warrenjb/footpod/case/case_preview.png

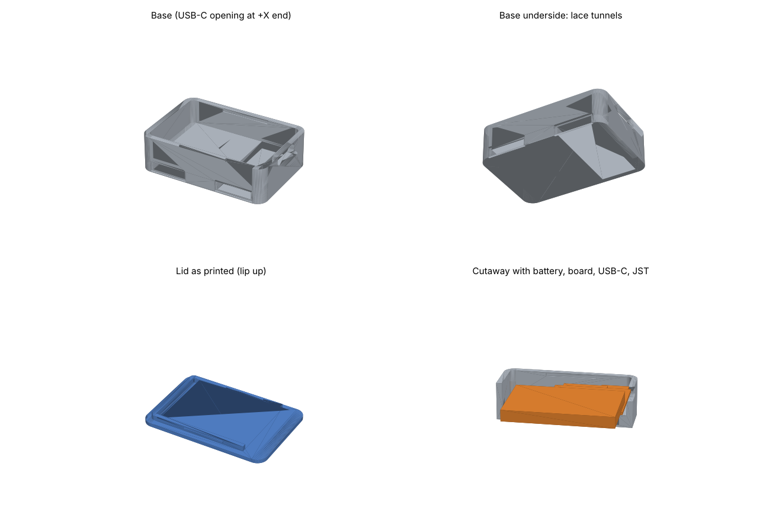
case/case_preview.png
