warrenjb/footpod/case/footpod_base.stl

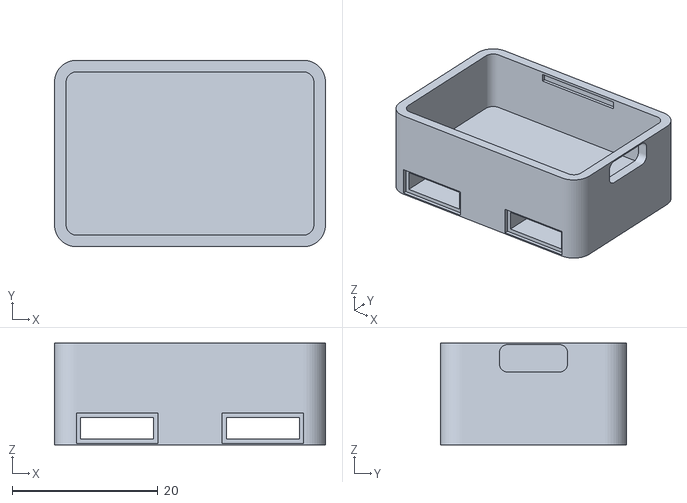
[picture p2: CAD file, 2026-10-12]
case/footpod_base.stl
37.2 x 25.6 x 14.0
