warrenjb/footpod/case/footpod_lid.stl

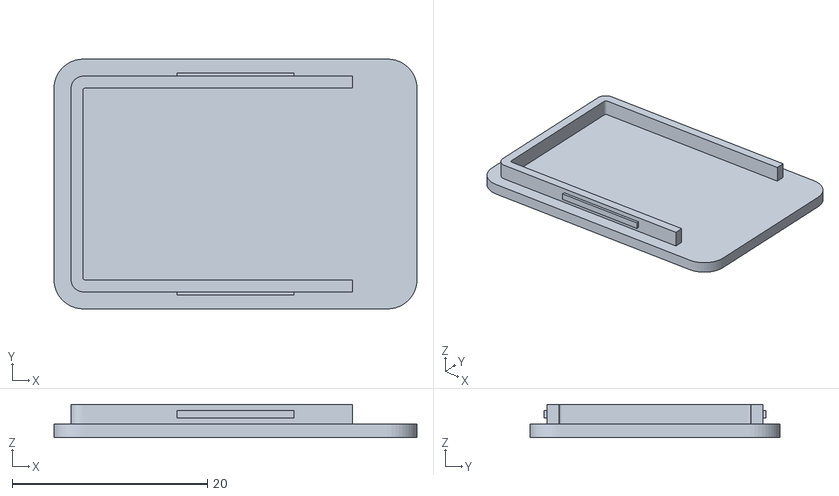
[picture p3: CAD file, 2026-10-12]
case/footpod_lid.stl
37.2 x 25.6 x 3.40
