warrenjb/footpod/case/slicing/z9v5pro_plaplus.ini

# PrusaSlicer profile: Zonestar Z9V5 Pro, 0.4 mm nozzle, 1.75 mm PLA+, foot pod case
printer_technology = FFF
gcode_flavor = marlin2
bed_shape = 0x0,300x0,300x300,0x300
max_print_height = 400
nozzle_diameter = 0.4
filament_diameter = 1.75
use_relative_e_distances = 1
layer_gcode = G92 E0
retract_length = 5
retract_speed = 40
retract_lift = 0.2
retract_before_travel = 1.5
wipe = 1
temperature = 210
first_layer_temperature = 215
bed_temperature = 60
first_layer_bed_temperature = 60
filament_type = PLA
cooling = 1
min_fan_speed = 100
max_fan_speed = 100
bridge_fan_speed = 100
disable_fan_first_layers = 1
layer_height = 0.16
first_layer_height = 0.2
perimeters = 4
top_solid_layers = 6
bottom_solid_layers = 5
fill_density = 30%
fill_pattern = gyroid
external_perimeters_first = 0
seam_position = rear
perimeter_speed = 50
external_perimeter_speed = 25
small_perimeter_speed = 20
infill_speed = 60
solid_infill_speed = 50
top_solid_infill_speed = 25
bridge_speed = 20
first_layer_speed = 20
travel_speed = 120
support_material = 0
skirts = 2
skirt_distance = 4
brim_width = 0
extrusion_width = 0.45
first_layer_extrusion_width = 0.5
thick_bridges = 1
start_gcode = ; Zonestar Z9V5 Pro start\nM140 S[first_layer_bed_temperature]\nM104 S160 ; warm nozzle without oozing\nG90\nM83\nG28 ; home all axes\nM420 S1 ; use the saved bed mesh (replace with G29 to probe every print)\nM190 S[first_layer_bed_temperature]\nT0 ; extruder 1 - load the PETG there\nM109 S[first_layer_temperature]\nG92 E0\nG1 Z2 F600\nG1 X5 Y20 F6000\nG1 Z0.3 F600\nG1 Y200 E15 F1200 ; prime line\nG1 X5.5 F6000\nG1 Y20 E15 F1200\nG92 E0\nG1 Z1 F600
end_gcode = ; end\nG91\nG1 E-2 F1800\nG1 Z10 F600\nG90\nG1 X10 Y290 F6000 ; present the bed\nM104 S0\nM140 S0\nM107\nM84
