warrenjb/footpod/(commit log)

2026-10-12 Add lace-mounted case STLs and generator
    Claude-Session: https://claude.ai/code/session_01B5wQo3N6tS7YEa3fiRti6i
    [footpod_base.stl, footpod_lid.stl]
2026-10-14 Add Z9V5 Pro PETG slicer profile and G-code for the case
    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
2026-10-14 Add PLA+ profile and G-code for the case
    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
2026-10-15 Add combined plates: one set and two sets, PLA+ and PETG
    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
2026-10-18 Print sleep status (USB, connected, still time) in the serial stats line
    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
2026-10-19 Fix sleep: offset-proof motion detection, quiet INT1 before sleeping, wake signal, honest still counter on USB
    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
    [footpod_capture.ino]
2026-10-19 Turn the blue LED off before sleeping (library drives it with inverted polarity)
    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
    [footpod_capture.ino]
2026-10-19 Add splash page, leg-lift counter, Supabase saving and dashboard
    - index.html: choose Running, Leg lifts or Dashboard
    - legs.html: four leg-raise exercises, per-leg or together counting, tunable thresholds
    - run.html (was footpod.html): saves run summaries with cadence series
    - dashboard.html: runs and leg-lift charts, recent sessions with delete
    - shared pod.js / db.js / style.css; footpod.html redirects to run.html
    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
2026-10-20 Sleep after 5 min still even when connected; reliable wake marker; slope wake filter; show awake time and sleep count
    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
2026-10-20 Only sustained movement resets the sleep timer; report the size of the last movement
    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
    [footpod_capture.ino, footpod_capture_R.ino]
2026-10-22 Battery level: read VBAT (sense kept enabled per Seeed guidance), show % and volts on the pages
    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
2026-10-31 Mounting check: name the buttons in the instructions
    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
2026-10-31 Fix stride over-counting: smooth gyro before detection, adaptive min stride gap, smoothed calibration; average cadence in run summary
    Tested on a real 40-minute walk/jog recording: old detector counted 7,579 steps vs ~5,113;
    new detector is within 1-2 strides per minute with or without calibration.
    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
